ClayFlannigan/Balanbot/code/vs2010/PIDADJ/PIDADJ/Debug/BuildLog.htm

生成日志

| | 生成 已启动: 项目: PIDADJ，配置: Debug|Win32

命令行

正在创建临时文件“e:\balace car\vs2008\PIDADJ\PIDADJ\Debug\RSP00002058802560.rsp”，其内容为
[
/Od /D "WIN32" /D "_WINDOWS" /D "_DEBUG" /D "_AFXDLL" /D "_UNICODE" /D "UNICODE" /Gm /EHsc /RTC1 /MDd /Yu"stdafx.h" /Fp"Debug\PIDADJ.pch" /Fo"Debug\\" /Fd"Debug\vc90.pdb" /W3 /c /ZI /TP ".\SerialPort.cpp"
]
正在创建命令行“cl.exe @"e:\balace car\vs2008\PIDADJ\PIDADJ\Debug\RSP00002058802560.rsp" /nologo /errorReport:prompt”
正在创建临时文件“e:\balace car\vs2008\PIDADJ\PIDADJ\Debug\RSP00002158802560.rsp”，其内容为
[
/OUT:"E:\balace car\vs2008\PIDADJ\Debug\PIDADJ.exe" /INCREMENTAL /MANIFEST /MANIFESTFILE:"Debug\PIDADJ.exe.intermediate.manifest" /MANIFESTUAC:"level='asInvoker' uiAccess='false'" /DEBUG /PDB:"e:\balace car\vs2008\PIDADJ\Debug\PIDADJ.pdb" /SUBSYSTEM:WINDOWS /ENTRY:"wWinMainCRTStartup" /DYNAMICBASE /NXCOMPAT /MACHINE:X86 ".\Debug\PIDADJ.obj"

".\Debug\PIDADJDlg.obj"

".\Debug\SerialPort.obj"

".\Debug\stdafx.obj"

".\Debug\PIDADJ.res"

".\Debug\PIDADJ.exe.embed.manifest.res"
]
正在创建命令行“link.exe @"e:\balace car\vs2008\PIDADJ\PIDADJ\Debug\RSP00002158802560.rsp" /NOLOGO /ERRORREPORT:PROMPT”
正在创建临时文件“e:\balace car\vs2008\PIDADJ\PIDADJ\Debug\RSP00002258802560.rsp”，其内容为
[
/out:".\Debug\PIDADJ.exe.embed.manifest" /notify_update /manifest

".\Debug\PIDADJ.exe.intermediate.manifest"
]
正在创建命令行“mt.exe @"e:\balace car\vs2008\PIDADJ\PIDADJ\Debug\RSP00002258802560.rsp" /nologo”
正在创建临时文件“e:\balace car\vs2008\PIDADJ\PIDADJ\Debug\BAT00002358802560.bat”，其内容为
[
@echo 清单资源上次更新时间为 %TIME%，更新位置为 %DATE% > ".\Debug\mt.dep"
]
正在创建命令行“""e:\balace car\vs2008\PIDADJ\PIDADJ\Debug\BAT00002358802560.bat""”

输出窗口

正在编译...
SerialPort.cpp
e:\balace car\vs2008\pidadj\pidadj\serialport.cpp(136) : warning C4996: 'sprintf': This function or variable may be unsafe. Consider using sprintf_s instead. To disable deprecation, use _CRT_SECURE_NO_WARNINGS. See online help for details.
c:\program files (x86)\microsoft visual studio 9.0\vc\include\stdio.h(366) : 参见“sprintf”的声明
e:\balace car\vs2008\pidadj\pidadj\serialport.cpp(137) : warning C4996: 'sprintf': This function or variable may be unsafe. Consider using sprintf_s instead. To disable deprecation, use _CRT_SECURE_NO_WARNINGS. See online help for details.
c:\program files (x86)\microsoft visual studio 9.0\vc\include\stdio.h(366) : 参见“sprintf”的声明
e:\balace car\vs2008\pidadj\pidadj\serialport.cpp(422) : warning C4996: 'sprintf': This function or variable may be unsafe. Consider using sprintf_s instead. To disable deprecation, use _CRT_SECURE_NO_WARNINGS. See online help for details.
c:\program files (x86)\microsoft visual studio 9.0\vc\include\stdio.h(366) : 参见“sprintf”的声明
e:\balace car\vs2008\pidadj\pidadj\serialport.cpp(661) : warning C4018: “>”: 有符号/无符号不匹配
正在链接...
正在嵌入清单...

结果

| | 生成日志保存在“file://e:\balace car\vs2008\PIDADJ\PIDADJ\Debug\BuildLog.htm” PIDADJ - 0 个错误，4 个警告
