ClayFlannigan/Balanbot/code/vs2010/PIDADJ/PIDADJ/Release/BuildLog.htm

生成日志

| | 生成 已启动: 项目: PIDADJ，配置: Release|Win32

命令行

正在创建临时文件“e:\balace car\vs2008\PIDADJ\PIDADJ\Release\RSP00000D58684452.rsp”，其内容为
[
/OUT:"E:\balace car\vs2008\PIDADJ\Release\PIDADJ.exe" /INCREMENTAL:NO /MANIFEST /MANIFESTFILE:"Release\PIDADJ.exe.intermediate.manifest" /MANIFESTUAC:"level='asInvoker' uiAccess='false'" /DEBUG /PDB:"e:\balace car\vs2008\PIDADJ\Release\PIDADJ.pdb" /SUBSYSTEM:WINDOWS /OPT:REF /OPT:ICF /LTCG /ENTRY:"wWinMainCRTStartup" /DYNAMICBASE /NXCOMPAT /MACHINE:X86 ".\Release\PIDADJ.obj"

".\Release\PIDADJDlg.obj"

".\Release\SerialPort.obj"

".\Release\stdafx.obj"

".\Release\PIDADJ.res"
]
正在创建命令行“link.exe @"e:\balace car\vs2008\PIDADJ\PIDADJ\Release\RSP00000D58684452.rsp" /NOLOGO /ERRORREPORT:PROMPT”
正在创建临时文件“e:\balace car\vs2008\PIDADJ\PIDADJ\Release\RSP00000E58684452.rsp”，其内容为
[
/outputresource:"..\Release\PIDADJ.exe;#1" /manifest

".\Release\PIDADJ.exe.intermediate.manifest"
]
正在创建命令行“mt.exe @"e:\balace car\vs2008\PIDADJ\PIDADJ\Release\RSP00000E58684452.rsp" /nologo”
正在创建临时文件“e:\balace car\vs2008\PIDADJ\PIDADJ\Release\BAT00000F58684452.bat”，其内容为
[
@echo 清单资源上次更新时间为 %TIME%，更新位置为 %DATE% > ".\Release\mt.dep"
]
正在创建命令行“""e:\balace car\vs2008\PIDADJ\PIDADJ\Release\BAT00000F58684452.bat""”

输出窗口

| | 正在链接... 正在生成代码 已完成代码的生成 正在嵌入清单...

结果

| | 生成日志保存在“file://e:\balace car\vs2008\PIDADJ\PIDADJ\Release\BuildLog.htm” PIDADJ - 0 个错误，0 个警告
