ClayFlannigan/Balanbot/sch/Balance Shield v2.0.pdf

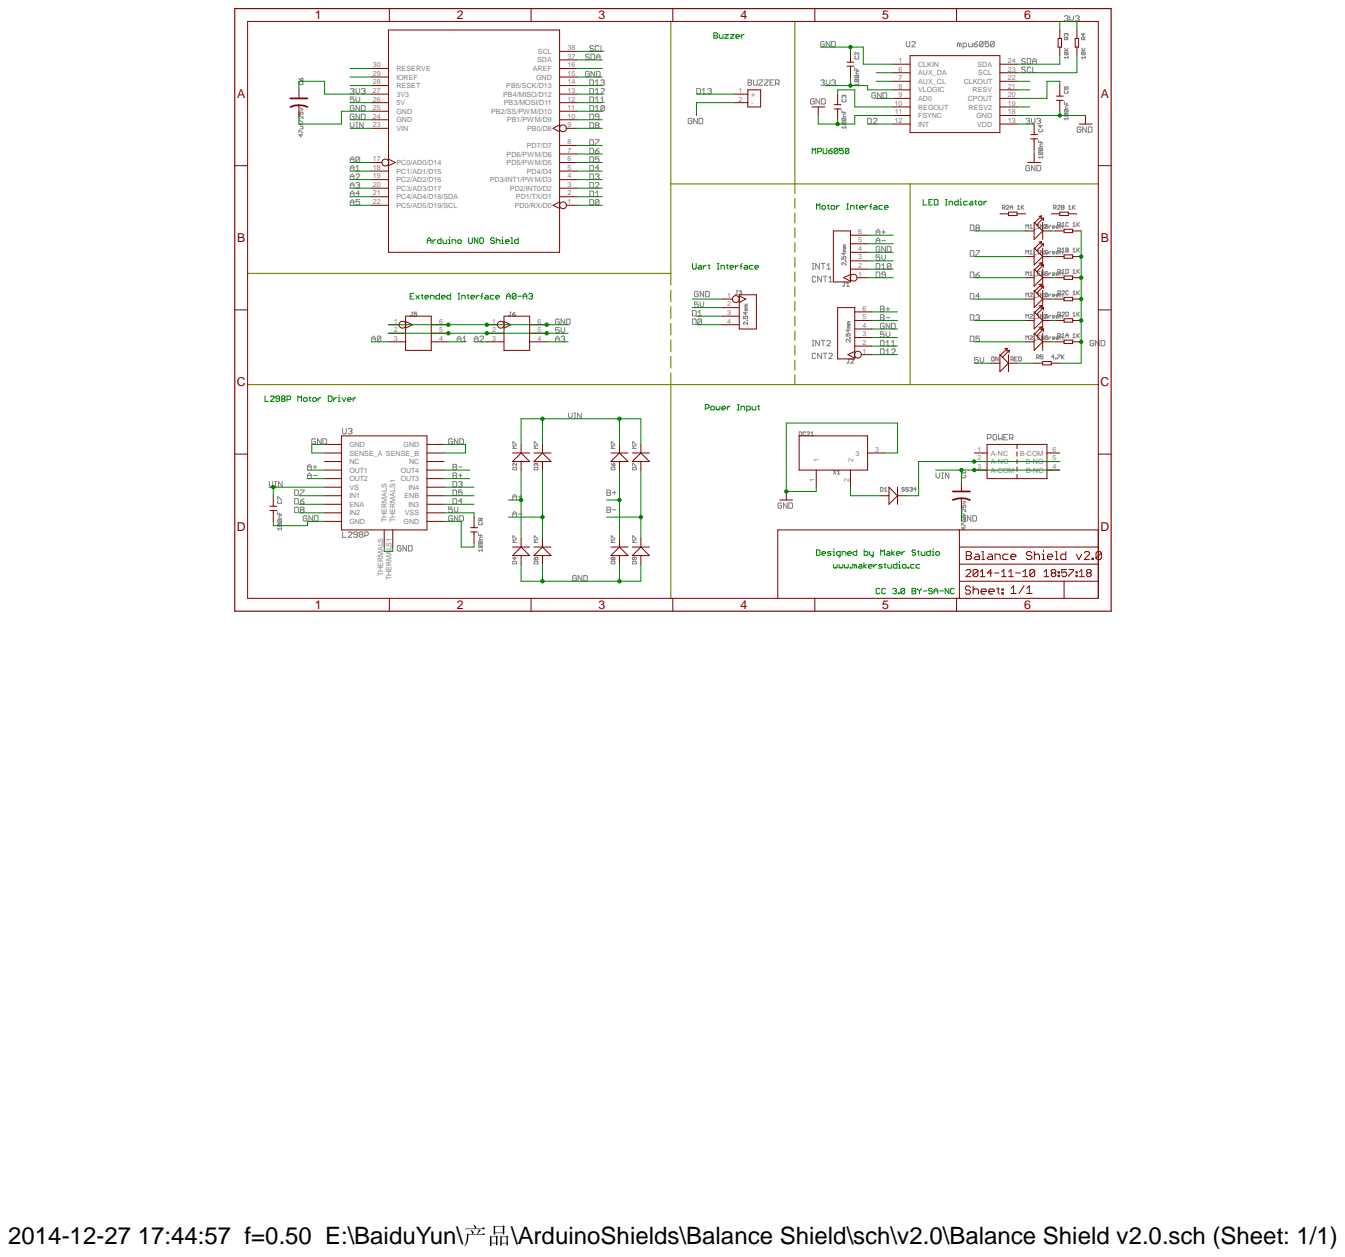
[picture p7: page 1]
2014-12-27 17:44:57 f=0.50 E:\BaiduYun\; \ArduinoShields\Balance Shield\sch\v2.0\Balance Shield v2.0.sch (Sheet: 1/1); PD2/INT0/D2; PD3/INT1/PWM/D3; PD5/PWM/D5; PD6/PWM/D6; PB1/PWM/D9; 10 PB2/SS/PWM/D10; 11 PB3/MOSI/D11; 12 PB4/MISO/D12; 13 PB5/SCK/D13; 14 GND; 15 AREF; 16 RESERVE 30; IOREF 29 RESET 28 3V3 27 5V 26 GND 25 GND 24 VIN 23; PC0/AD0/D14 17 PC1/AD1/D15 18 PC2/AD2/D16 19 PC3/AD3/D17 20 PC4/AD4/D18/SDA 21 PC5/AD5/D19/SCL 22; SDA; 37 SCL; B-COM 6; A-COM 3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
