ClayFlannigan/Balanbot/code/vs2010/PIDADJ/PIDADJ/PIDADJ.h

// PIDADJ.h : PROJECT_NAME 应用程序的主头文件
//

#pragma once

#ifndef __AFXWIN_H__
	#error "在包含此文件之前包含“stdafx.h”以生成 PCH 文件"
#endif

#include "resource.h"		// 主符号


// CPIDADJApp:
// 有关此类的实现，请参阅 PIDADJ.cpp
//

class CPIDADJApp : public CWinApp
{
public:
	CPIDADJApp();

// 重写
	public:
	virtual BOOL InitInstance();

// 实现

	DECLARE_MESSAGE_MAP()
};

extern CPIDADJApp theApp;
