ClayFlannigan/Balanbot/code/vs2010/PIDADJ/PIDADJ/SerialPort.cpp

//CSerialPortEx类是在Remon Spekreijse设计的CSerialPort类基础上设计的，并增加
//了对二进制数据传输和块读写方式的支持和其他功能函数。关于CSerialPort类的声明如下：

/*
**	FILENAME			CSerialPortEx.cpp
**
**	PURPOSE				This class can read, write and watch one serial port.
**						It sends messages to its owner when something happends on the port
**						The class creates a thread for reading and writing so the main
**						program is not blocked.
**
**	CREATION DATE		15-09-1997
**	LAST MODIFICATION	12-11-1997
**
**	AUTHOR				Remon Spekreijse
**
**
*/

#include "stdafx.h"
#include "SerialPort.h"

#include <assert.h>
 
//
// Constructor
//
CSerialPortEx::CSerialPortEx()
{
	m_hComm = NULL;

	// initialize overlapped structure members to zero
	m_ov.Offset = 0;
	m_ov.OffsetHigh = 0;

	// create events
	m_ov.hEvent = NULL;
	m_hWriteEvent = NULL;
	m_hShutdownEvent = NULL;

	m_szWriteBuffer = NULL;

	m_bThreadAlive = FALSE;
	m_bBlockRead=FALSE;
}

//
// Delete dynamic memory
//
CSerialPortEx::~CSerialPortEx()
{
	do
	{
		SetEvent(m_hShutdownEvent);
	} while (m_bThreadAlive);

	TRACE("Thread ended\n");

	delete [] m_szWriteBuffer;
}

//
// Initialize the port. This can be port 1 to 4.
//
BOOL CSerialPortEx::InitPort(CWnd* pPortOwner,	// the owner (CWnd) of the port (receives message)
						   UINT  portnr,		// portnumber (1..4)
						   UINT  baud,			// baudrate
						   char  parity,		// parity 
						   UINT  databits,		// databits 
						   UINT  stopbits,		// stopbits 
						   DWORD dwCommEvents,	// EV_RXCHAR, EV_CTS etc
						   UINT  writebuffersize)	// size to the writebuffer
{
	assert(portnr > 0 && portnr < 5);
	assert(pPortOwner != NULL);

	// if the thread is alive: Kill
	if (m_bThreadAlive)
	{
		do
		{
			SetEvent(m_hShutdownEvent);
		} while (m_bThreadAlive);
		TRACE("Thread ended\n");
	}

	// create events
	if (m_ov.hEvent != NULL)
		ResetEvent(m_ov.hEvent);
	m_ov.hEvent = CreateEvent(NULL, TRUE, FALSE, NULL);

	if (m_hWriteEvent != NULL)
		ResetEvent(m_hWriteEvent);
	m_hWriteEvent = CreateEvent(NULL, TRUE, FALSE, NULL);
	
	if (m_hShutdownEvent != NULL)
		ResetEvent(m_hShutdownEvent);
	m_hShutdownEvent = CreateEvent(NULL, TRUE, FALSE, NULL);

	// initialize the event objects
	m_hEventArray[0] = m_hShutdownEvent;	// highest priority
	m_hEventArray[1] = m_ov.hEvent;
	m_hEventArray[2] = m_hWriteEvent;

	// initialize critical section
	InitializeCriticalSection(&m_csCommunicationSync);
	
	// set buffersize for writing and save the owner
	m_pOwner = pPortOwner;

	if (m_szWriteBuffer != NULL)
		delete [] m_szWriteBuffer;
	m_szWriteBuffer =new BYTE[writebuffersize];

	m_nPortNr = portnr;

	m_nWriteBufferSize = writebuffersize;
	m_dwCommEvents = dwCommEvents;

	BOOL bResult = FALSE;
	char *szPort = new char[50];
	char *szBaud = new char[50];

	// now it critical!
	EnterCriticalSection(&m_csCommunicationSync);

	// if the port is already opened: close it
	if (m_hComm != NULL)
	{
		CloseHandle(m_hComm);
		m_hComm = NULL;
	}

	// prepare port strings
	sprintf(szPort, "COM%d", portnr);
	sprintf(szBaud, "baud=%d parity=%c data=%d stop=%d", baud, parity, databits, stopbits);

	// get a handle to the port
	m_hComm = CreateFile(CA2W(szPort),						// communication port string (COMX)
					     GENERIC_READ | GENERIC_WRITE,	// read/write types
					     0,								// comm devices must be opened with exclusive access
					     NULL,							// no security attributes
					     OPEN_EXISTING,					// comm devices must use OPEN_EXISTING
					     FILE_FLAG_OVERLAPPED,			// Async I/O
					     0);							// template must be 0 for comm devices

	if (m_hComm == INVALID_HANDLE_VALUE)
	{
		// port not found
		delete [] szPort;
		delete [] szBaud;

		return FALSE;
	}

	// set the timeout values
	m_CommTimeouts.ReadIntervalTimeout = 1000;
	m_CommTimeouts.ReadTotalTimeoutMultiplier = 1000;
	m_CommTimeouts.ReadTotalTimeoutConstant = 1000;
	m_CommTimeouts.WriteTotalTimeoutMultiplier = 1000;
	m_CommTimeouts.WriteTotalTimeoutConstant = 1000;

	// configure
	if (SetCommTimeouts(m_hComm, &m_CommTimeouts))
	{						   
		if (SetCommMask(m_hComm, dwCommEvents))
		{
			if (GetCommState(m_hComm, &m_dcb))
			{
				m_dcb.fRtsControl = RTS_CONTROL_ENABLE;		// set RTS bit high!
				if (BuildCommDCB(CA2W(szBaud), &m_dcb))
				{
					if (SetCommState(m_hComm, &m_dcb))
						; // normal operation... continue
					else
						ProcessErrorMessage("SetCommState()");
				}
				else
					ProcessErrorMessage("BuildCommDCB()");
			}
			else
				ProcessErrorMessage("GetCommState()");
		}
		else
			ProcessErrorMessage("SetCommMask()");
	}
	else
		ProcessErrorMessage("SetCommTimeouts()");

	delete [] szPort;
	delete [] szBaud;

	// flush the port
	PurgeComm(m_hComm, PURGE_RXCLEAR | PURGE_TXCLEAR | PURGE_RXABORT | PURGE_TXABORT);

	// release critical section
	LeaveCriticalSection(&m_csCommunicationSync);

	TRACE("Initialisation for communicationport %d completed.\nUse Startmonitor to communicate.\n", portnr);

	return TRUE;
}

//
//  The CommThread Function.
//
UINT CSerialPortEx::CommThread(LPVOID pParam)
{
	// Cast the void pointer passed to the thread back to
	// a pointer of CSerialPortEx class
	CSerialPortEx *port = (CSerialPortEx*)pParam;
	
	// Set the status variable in the dialog class to
	// TRUE to indicate the thread is running.
	port->m_bThreadAlive = TRUE;	
		
	// Misc. variables
	DWORD BytesTransfered = 0; 
	DWORD Event = 0;
	DWORD CommEvent = 0;
	DWORD dwError = 0;
	COMSTAT comstat;
	BOOL  bResult = TRUE;
		
	// Clear comm buffers at startup
	if (port->m_hComm)		// check if the port is opened
		PurgeComm(port->m_hComm, PURGE_RXCLEAR | PURGE_TXCLEAR | PURGE_RXABORT | PURGE_TXABORT);

	// begin forever loop.  This loop will run as long as the thread is alive.
	for (;;) 
	{ 

		// Make a call to WaitCommEvent().  This call will return immediatly
		// because our port was created as an async port (FILE_FLAG_OVERLAPPED
		// and an m_OverlappedStructerlapped structure specified).  This call will cause the 
		// m_OverlappedStructerlapped element m_OverlappedStruct.hEvent, which is part of the m_hEventArray to 
		// be placed in a non-signeled state if there are no bytes available to be read,
		// or to a signeled state if there are bytes available.  If this event handle 
		// is set to the non-signeled state, it will be set to signeled when a 
		// character arrives at the port.

		// we do this for each port!

		bResult = WaitCommEvent(port->m_hComm, &Event, &port->m_ov);

		if (!bResult)  
		{ 
			// If WaitCommEvent() returns FALSE, process the last error to determin
			// the reason..
			switch (dwError = GetLastError()) 
			{ 
			case ERROR_IO_PENDING: 	
				{ 
					// This is a normal return value if there are no bytes
					// to read at the port.
					// Do nothing and continue
					break;
				}
			case 87:
				{
					// Under Windows NT, this value is returned for some reason.
					// I have not investigated why, but it is also a valid reply
					// Also do nothing and continue.
					break;
				}
			default:
				{
					// All other error codes indicate a serious error has
					// occured.  Process this error.
					port->ProcessErrorMessage("WaitCommEvent()");
					break;
				}
			}
		}
		else
		{
			// If WaitCommEvent() returns TRUE, check to be sure there are
			// actually bytes in the buffer to read.  
			//
			// If you are reading more than one byte at a time from the buffer 
			// (which this program does not do) you will have the situation occur 
			// where the first byte to arrive will cause the WaitForMultipleObjects() 
			// function to stop waiting.  The WaitForMultipleObjects() function 
			// resets the event handle in m_OverlappedStruct.hEvent to the non-signelead state
			// as it returns.  
			//
			// If in the time between the reset of this event and the call to 
			// ReadFile() more bytes arrive, the m_OverlappedStruct.hEvent handle will be set again
			// to the signeled state. When the call to ReadFile() occurs, it will 
			// read all of the bytes from the buffer, and the program will
			// loop back around to WaitCommEvent().
			// 
			// At this point you will be in the situation where m_OverlappedStruct.hEvent is set,
			// but there are no bytes available to read.  If you proceed and call
			// ReadFile(), it will return immediatly due to the async port setup, but
			// GetOverlappedResults() will not return until the next character arrives.
			//
			// It is not desirable for the GetOverlappedResults() function to be in 
			// this state.  The thread shutdown event (event 0) and the WriteFile()
			// event (Event2) will not work if the thread is blocked by GetOverlappedResults().
			//
			// The solution to this is to check the buffer with a call to ClearCommError().
			// This call will reset the event handle, and if there are no bytes to read
			// we can loop back through WaitCommEvent() again, then proceed.
			// If there are really bytes to read, do nothing and proceed.
		
			bResult = ClearCommError(port->m_hComm, &dwError, &comstat);

			if (comstat.cbInQue == 0)
				continue;
		}	// end if bResult

		// Main wait function.  This function will normally block the thread
		// until one of nine events occur that require action.
		Event = WaitForMultipleObjects(3, port->m_hEventArray, FALSE, INFINITE);

		switch (Event)
		{
		case 0:
			{
				// Shutdown event.  This is event zero so it will be
				// the higest priority and be serviced first.

			 	port->m_bThreadAlive = FALSE;
				
				// Kill this thread.  break is not needed, but makes me feel better.
				AfxEndThread(100);
				break;
			}
		case 1:	// read event
			{
				GetCommMask(port->m_hComm, &CommEvent);
				if (CommEvent & EV_CTS)
					::SendMessage(port->m_pOwner->m_hWnd, WM_COMM_CTS_DETECTED, (WPARAM) 0, (LPARAM) port->m_nPortNr);
				if (CommEvent & EV_RXFLAG)
					::SendMessage(port->m_pOwner->m_hWnd, WM_COMM_RXFLAG_DETECTED, (WPARAM) 0, (LPARAM) port->m_nPortNr);
				if (CommEvent & EV_BREAK)
					::SendMessage(port->m_pOwner->m_hWnd, WM_COMM_BREAK_DETECTED, (WPARAM) 0, (LPARAM) port->m_nPortNr);
				if (CommEvent & EV_ERR)
					::SendMessage(port->m_pOwner->m_hWnd, WM_COMM_ERR_DETECTED, (WPARAM) 0, (LPARAM) port->m_nPortNr);
				if (CommEvent & EV_RING)
					::SendMessage(port->m_pOwner->m_hWnd, WM_COMM_RING_DETECTED, (WPARAM) 0, (LPARAM) port->m_nPortNr);
				
				if (CommEvent & EV_RXCHAR)
					// Receive character event from port.
					if(!port->m_bBlockRead)
						ReceiveChar(port, comstat);
					
				break;
			}  
		case 2: // write event
			{
				// Write character event from port
				WriteChar(port);
				break;
			}

		} // end switch

	} // close forever loop

	return 0;
}

//
// start comm watching
//
BOOL CSerialPortEx::StartMonitoring()
{
	if (!(m_Thread = AfxBeginThread(CommThread, this)))
		return FALSE;
	TRACE("Thread started\n");
	return TRUE;	
}

//
// Restart the comm thread
//
BOOL CSerialPortEx::RestartMonitoring()
{
	TRACE("Thread resumed\n");
	m_Thread->ResumeThread();
	return TRUE;	
}


//
// Suspend the comm thread
//
BOOL CSerialPortEx::StopMonitoring()
{
	TRACE("Thread suspended\n");
	if(m_bThreadAlive)
	{
		m_Thread->SuspendThread(); 
		m_bThreadAlive=FALSE;
	}
	return TRUE;	
}


//
// If there is a error, give the right message
//
void CSerialPortEx::ProcessErrorMessage(char* ErrorText)
{
	char *Temp = new char[200];
	
	LPVOID lpMsgBuf;

	FormatMessage( 
		FORMAT_MESSAGE_ALLOCATE_BUFFER | FORMAT_MESSAGE_FROM_SYSTEM,
		NULL,
		GetLastError(),
		MAKELANGID(LANG_NEUTRAL, SUBLANG_DEFAULT), // Default language
		(LPTSTR) &lpMsgBuf,
		0,
		NULL 
	);

	sprintf(Temp, "WARNING:  %s Failed with the following error: \n%s\nPort: %d\n", (char*)ErrorText, lpMsgBuf, m_nPortNr); 
	MessageBox(NULL, CA2W(Temp), L"Application Error", MB_ICONSTOP);

	LocalFree(lpMsgBuf);
	delete[] Temp;
}

//
// Write a character.
//
void CSerialPortEx::WriteChar(CSerialPortEx* port)
{
	BOOL bWrite = TRUE;
	BOOL bResult = TRUE;

	DWORD BytesSent = 0;

	ResetEvent(port->m_hWriteEvent);

	// Gain ownership of the critical section
	EnterCriticalSection(&port->m_csCommunicationSync);

	if (bWrite)
	{
		// Initailize variables
		port->m_ov.Offset = 0;
		port->m_ov.OffsetHigh = 0;

		// Clear buffer
		PurgeComm(port->m_hComm, PURGE_RXCLEAR | PURGE_TXCLEAR | PURGE_RXABORT | PURGE_TXABORT);

		bResult = WriteFile(port->m_hComm,							// Handle to COMM Port
							port->m_szWriteBuffer,					// Pointer to message buffer in calling finction
							port->m_nToSend,								// Length of message to send
							&BytesSent,								// Where to store the number of bytes sent
							&port->m_ov);							// Overlapped structure

		// deal with any error codes
		if (!bResult)  
		{
			DWORD dwError = GetLastError();
			switch (dwError)
			{
				case ERROR_IO_PENDING:
					{
						// continue to GetOverlappedResults()
						BytesSent = 0;
						bWrite = FALSE;
						break;
					}
				default:
					{
						// all other error codes
						port->ProcessErrorMessage("WriteFile()");
					}
			}
		} 
		else
		{
			LeaveCriticalSection(&port->m_csCommunicationSync);
		}
	} // end if(bWrite)

	if (!bWrite)
	{
		bWrite = TRUE;
	
		bResult = GetOverlappedResult(port->m_hComm,	// Handle to COMM port 
									  &port->m_ov,		// Overlapped structure
									  &BytesSent,		// Stores number of bytes sent
									  TRUE); 			// Wait flag

		LeaveCriticalSection(&port->m_csCommunicationSync);

		// deal with the error code 
		if (!bResult)  
		{
			port->ProcessErrorMessage("GetOverlappedResults() in WriteFile()");
		}	
	} // end if (!bWrite)

	// Verify that the data size send equals what we tried to send
	if (BytesSent != port->m_nToSend)
	{
		TRACE("WARNING: WriteFile() error.. Bytes Sent: %d; Message Length: %d\n", BytesSent, strlen((char*)port->m_szWriteBuffer));
	}
}

//
// Character received. Inform the owner
//
void CSerialPortEx::ReceiveChar(CSerialPortEx* port, COMSTAT comstat)
{
	BOOL  bRead = TRUE; 
	BOOL  bResult = TRUE;
	DWORD dwError = 0;
	DWORD BytesRead = 0;
	unsigned char RXBuff=0;

	for (;;) 
	{ 
		// Gain ownership of the comm port critical section.
		// This process guarantees no other part of this program 
		// is using the port object. 
		
		EnterCriticalSection(&port->m_csCommunicationSync);

		// ClearCommError() will update the COMSTAT structure and
		// clear any other errors.
		
		bResult = ClearCommError(port->m_hComm, &dwError, &comstat);

		LeaveCriticalSection(&port->m_csCommunicationSync);

		// start forever loop.  I use this type of loop because I
		// do not know at runtime how many loops this will have to
		// run. My solution is to start a forever loop and to
		// break out of it when I have processed all of the
		// data available.  Be careful with this approach and
		// be sure your loop will exit.
		// My reasons for this are not as clear in this sample 
		// as it is in my production code, but I have found this 
		// solutiion to be the most efficient way to do this.
		
		if (comstat.cbInQue == 0)
		{
			// break out when all bytes have been read
			break;
		}
						
		EnterCriticalSection(&port->m_csCommunicationSync);

		if (bRead)
		{
			bResult = ReadFile(port->m_hComm,		// Handle to COMM port 
							   &RXBuff,				// RX Buffer Pointer
							   1,					// Read one byte
							   &BytesRead,			// Stores number of bytes read
							   &port->m_ov);		// pointer to the m_ov structure
			// deal with the error code 
			if (!bResult)  
			{ 
				switch (dwError = GetLastError()) 
				{ 
					case ERROR_IO_PENDING: 	
						{ 
							// asynchronous i/o is still in progress 
							// Proceed on to GetOverlappedResults();
							bRead = FALSE;
							break;
						}
					default:
						{
							// Another error has occured.  Process this error.
							port->ProcessErrorMessage("ReadFile()");
							break;
						} 
				}
			}
			else
			{
				// ReadFile() returned complete. It is not necessary to call GetOverlappedResults()
				bRead = TRUE;
			}
		}  // close if (bRead)

		if (!bRead)
		{
			bRead = TRUE;
			bResult = GetOverlappedResult(port->m_hComm,	// Handle to COMM port 
										  &port->m_ov,		// Overlapped structure
										  &BytesRead,		// Stores number of bytes read
										  TRUE); 			// Wait flag

			// deal with the error code 
			if (!bResult)  
			{
				port->ProcessErrorMessage("GetOverlappedResults() in ReadFile()");
			}	
		}  // close if (!bRead)
				
		LeaveCriticalSection(&port->m_csCommunicationSync);

		// notify parent that a byte was received
		::SendMessage((port->m_pOwner)->m_hWnd, WM_COMM_RXCHAR, (WPARAM) RXBuff, (LPARAM) port->m_nPortNr);
	} // end forever loop		

}

//
// Write a string to the port
//
void CSerialPortEx::WriteToPort(BYTE* string,int nLength)
{		
//	assert(m_hComm != 0);
	if(m_hComm==0) 
	{
		::AfxMessageBox(L"error strange");
		return;
	}
	
	memset(m_szWriteBuffer, 0, m_nWriteBufferSize);
	memcpy(m_szWriteBuffer, string,nLength);
	m_nToSend=nLength;

	// set event for write
	SetEvent(m_hWriteEvent);
}

//
// Return the device control block
//
DCB CSerialPortEx::GetDCB()
{
	return m_dcb;
}

//
// Return the communication event masks
//
DWORD CSerialPortEx::GetCommEvents()
{
	return m_dwCommEvents;
}

//
// Return the output buffer size
//
DWORD CSerialPortEx::GetWriteBufferSize()
{
	return m_nWriteBufferSize;
}

//Extension: not tested
void CSerialPortEx::WriteToPort(CString str)
{
	
	char *buffer=new char[m_nWriteBufferSize];
	memset(buffer,0,m_nWriteBufferSize);
	int nMaxLength=(str.GetLength()+1 > m_nWriteBufferSize) ? str.GetLength()+1 : m_nWriteBufferSize;
	char *temp=CW2A(str.GetBuffer(nMaxLength));
	memcpy(buffer,temp,str.GetLength());
	str.ReleaseBuffer();
	WriteToPort((BYTE*)buffer,str.GetLength());
}

//Extension: not tested
//DEL int CSerialPortEx::ReadCommBlock(LPSTR lpszBlock, int nMaxLength)
//DEL {
//DEL    BOOL       fReadStat ;
//DEL    COMSTAT    ComStat ;
//DEL    DWORD      dwErrorFlags;
//DEL    DWORD      dwLength;
//DEL    DWORD      dwError;
//DEL 
//DEL    // only try to read number of bytes in queue
//DEL    BOOL ok=ClearCommError( m_hComm, &dwErrorFlags, &ComStat ) ;
//DEL    dwLength = min( (DWORD) nMaxLength, ComStat.cbInQue ) ;
//DEL 
//DEL    if (dwLength > 0)
//DEL    {
//DEL 	  fReadStat = ::ReadFile(m_hComm,lpszBlock,dwLength,&dwLength,&m_ov) ;
//DEL       if (!fReadStat)
//DEL       {
//DEL          if ((dwError=GetLastError()) == ERROR_IO_PENDING)
//DEL          {
//DEL 
//DEL             while(!GetOverlappedResult( m_hComm,
//DEL                &m_ov, &dwLength, TRUE ))
//DEL             {
//DEL                dwError = GetLastError();
//DEL                if(dwError == ERROR_IO_INCOMPLETE)
//DEL                   // normal result if not finished
//DEL                   continue;
//DEL                else
//DEL                {
//DEL                   // an error occurred, try to recover
//DEL                  ClearCommError( m_hComm, &dwErrorFlags, &ComStat ) ;
//DEL                   break;
//DEL                }
//DEL             }
//DEL 	      }
//DEL          else
//DEL          {
//DEL             // some other error occurred
//DEL             dwLength = 0 ;
//DEL             ClearCommError( m_hComm, &dwErrorFlags, &ComStat ) ;
//DEL           }
//DEL       }
//DEL    }
//DEL    return dwLength ;
//DEL }

//Extension: not tested

BYTE* CSerialPortEx::ReadBlock(CSerialPortEx *port, int& readLen)
{
	COMSTAT comstat;
	BOOL  bRead = TRUE; 
	BOOL  bResult = TRUE;
	DWORD dwError = 0;
	DWORD BytesRead = 0;
	DWORD BytesToRead=readLen;
	BYTE* pRec;


		// Gain ownership of the comm port critical section.
		// This process guarantees no other part of this program 
		// is using the port object. 
		
		EnterCriticalSection(&port->m_csCommunicationSync);

		// ClearCommError() will update the COMSTAT structure and
		// clear any other errors.
		
		bResult = ClearCommError(port->m_hComm, &dwError, &comstat);

		LeaveCriticalSection(&port->m_csCommunicationSync);

		// start forever loop.  I use this type of loop because I
		// do not know at runtime how many loops this will have to
		// run. My solution is to start a forever loop and to
		// break out of it when I have processed all of the
		// data available.  Be careful with this approach and
		// be sure your loop will exit.
		// My reasons for this are not as clear in this sample 
		// as it is in my production code, but I have found this 
		// solutiion to be the most efficient way to do this.
		
		if (comstat.cbInQue == 0)
		{
			// break out when all bytes have been read
			readLen=0;
			return NULL;
		}
		else
		{
			BytesToRead= BytesToRead+2 > comstat.cbInQue ? comstat.cbInQue : BytesToRead+2;
			pRec=new BYTE[BytesToRead];
		}

		EnterCriticalSection(&port->m_csCommunicationSync);

		if (bRead)
		{
			bResult = ReadFile(port->m_hComm,		// Handle to COMM port 
							   pRec,				// Reader Buffer Pointer
							   BytesToRead,			// to read bytes
							   &BytesRead,			// Stores number of bytes read
							   &port->m_ov);		// pointer to the m_ov structure
			// deal with the error code 
			if (!bResult)  
			{ 
				switch (dwError = GetLastError()) 
				{ 
					case ERROR_IO_PENDING: 	
						{ 
							// asynchronous i/o is still in progress 
							// Proceed on to GetOverlappedResults();
							bRead = FALSE;
							break;
						}
					default:
						{
							// Another error has occured.  Process this error.
							port->ProcessErrorMessage("ReadFile()");
							break;
						} 
				}
			}
			else
			{
				// ReadFile() returned complete. It is not necessary to call GetOverlappedResults()
				bRead = TRUE;
			}
		}  // close if (bRead)

		if (!bRead)
		{
			bRead = TRUE;
			bResult = GetOverlappedResult(port->m_hComm,	// Handle to COMM port 
										  &port->m_ov,		// Overlapped structure
										  &BytesRead,		// Stores number of bytes read
										  TRUE); 			// Wait flag

			// deal with the error code 
			if (!bResult)  
			{
				port->ProcessErrorMessage("GetOverlappedResults() in ReadFile()");
			}	
		}  // close if (!bRead)
				
		LeaveCriticalSection(&port->m_csCommunicationSync);
		
		readLen=BytesRead;
		return pRec;

		// notify parent that a byte was received
//		::SendMessage((port->m_pOwner)->m_hWnd, WM_COMM_RXCHAR, (WPARAM)pRec, (LPARAM) BytesRead);

}


void CSerialPortEx::ClosePort()
{
    MSG message;  
    do
    {
        SetEvent(m_hShutdownEvent);
        if(::PeekMessage(&message,m_pOwner->m_hWnd,0,0,PM_REMOVE))
        {
            ::TranslateMessage(&message);
            ::DispatchMessage(&message);
        }
               
    } while (m_bThreadAlive);

    // if the port is still opened: close it 
    if (m_hComm != NULL)
    {
        CloseHandle(m_hComm);
        m_hComm = NULL;
    }
    
    // Close Handles  
    if(m_hShutdownEvent!=NULL)
        ResetEvent(m_hShutdownEvent);
    if(m_ov.hEvent!=NULL)
        ResetEvent(m_ov.hEvent);
    if(m_hWriteEvent!=NULL)
        ResetEvent(m_hWriteEvent);            
        
    //delete [] m_szWriteBuffer;
    
}
