ClayFlannigan/Balanbot/code/vs2010/PIDADJ/PIDADJ/resource.h

//{{NO_DEPENDENCIES}}
// Microsoft Visual C++ generated include file.
// Used by PIDADJ.rc
//
#define IDM_ABOUTBOX                    0x0010
#define IDD_ABOUTBOX                    100
#define IDS_ABOUTBOX                    101
#define IDD_PIDADJ_DIALOG               102
#define IDR_MAINFRAME                   128
#define ID_OK                           1000
#define IDC_POS_KD                      1002
#define IDC_POS_KI                      1002
#define IDC_POS_KP                      1003
#define IDC_ANGLE_KP                    1004
#define IDC_ANGLE_KD                    1005
#define IDC_SHOW_A_KP                   1006
#define IDC_SHOW_A_KD                   1007
#define IDC_SHOW_P_KP                   1008
#define IDC_SHOW_P_KDD                  1009
#define IDC_SHOW_P_KI                   1009
#define IDC_BASE                        1010
#define IDC_COMBO1                      1011
#define IDC_OPEN_SPEED                  1012
#define IDC_OPEN_CONTROL                1012
#define IDC_OPEN_POS                    1013
#define IDC_SHOW_BASE                   1013
#define IDC_BUTTON1                     1016
#define IDC_BUTTON2                     1017
#define IDC_BUTTON3                     1018
#define IDC_BUTTON4                     1019
#define IDC_BUTTON5                     1020
#define IDC_READ_PID                    1020
#define IDC_WRITE_EEPROM                1021
#define IDC_BUTTON6                     1022
#define IDC_TIP                         1023
#define IDC_WORK                        1024
#define IDC_SLEEP_OFF                   1025
#define IDC_WORK2                       1026
#define IDC_POWE_OFF                    1026

// Next default values for new objects
// 
#ifdef APSTUDIO_INVOKED
#ifndef APSTUDIO_READONLY_SYMBOLS
#define _APS_NEXT_RESOURCE_VALUE        129
#define _APS_NEXT_COMMAND_VALUE         32771
#define _APS_NEXT_CONTROL_VALUE         1025
#define _APS_NEXT_SYMED_VALUE           101
#endif
#endif
